LAlejandroCM/AnemoSense/BOM_Board1_Schematic1_2026-07-04.xlsx

No. | Quantity | Comment | Designator | Footprint | Value | Manufacturer Part | Manufacturer | Supplier Part | Supplier
1 | 7 | 10uF | C1,C2,C3,C4,C5,C6,C7 | C0805 | 10uF | C0805X106K010T | IHHEC(禾伸堂) | C340314 | LCSC
2 | 2 | 100nF | C8,C9 | C0805 | 100nF | CC0805KRX7R9BB104 | YAGEO(国巨) | C49678 | LCSC
3 | 1 | PRTR5V0U2X | D1 | SOT-143-4_L2.9-W1.3-P1.92-LS2.4-BL |  | PRTR5V0U2X | TECH PUBLIC(台舟) | C2827688 | LCSC
4 | 1 | MBR120LSFT1G | D2 | SOD-123_L2.8-W1.8-LS3.7-RD-1 |  | MBR120LSFT1G | onsemi(安森美) | C891416 | LCSC
5 | 1 | PM254V-11-07-H85 | H1 | GC9A01 |  | PM254V-11-07-H85 | XFCN(兴飞) | C2832270 | LCSC
6 | 1 | YLED1206W | LED1 | LED1206-R-RD |  | YLED1206W | YONGYUTAI(永裕泰) | C28310437 | LCSC
7 | 2 | MMBT2222ALT1G | Q1,Q2 | SOT-23-3_L2.9-W1.3-P1.90-LS2.4-BR |  | MMBT2222ALT1G | onsemi(安森美) | C82460 | LCSC
8 | 3 | 10kΩ | R2,R3,R7 | R0805 | 10kΩ | SCR0805J10K | VO(翔胜) | C5140188 | LCSC
9 | 1 | 80.6kΩ | R4 | R0805 | 80.6kΩ | CR0805F88062G | LIZ(丽智电子) | C101871 | LCSC
10 | 2 | 5.1kΩ | R5,R6 | R0805 | 5.1kΩ | HoAR0805-1/8W-5.1KR-0.1%-TCR25 | Milliohm(毫欧) | C2912598 | LCSC
11 | 1 | 100kΩ | R8 | R0805 | 100kΩ | SCR0805J100K | VO(翔胜) | C3017875 | LCSC
12 | 4 | 4.7kΩ | R9,R10,R11,R12 | R0805 | 4.7kΩ | FRC0805F4701TS | FOJAN(富捷) | C2907264 | LCSC
13 | 2 | PTS820J25MSMTRLFS | SW1,SW2 | KEY-SMD_6P-L3.9-W2.9_PTS820 |  | PTS820J25MSMTRLFS | C&K | C221900 | LCSC
14 | 1 | SCD41-D-R2 | U1 | XDCR_SCD41-D-R2
15 | 1 | CH340C | U2 | SOP-16_L10.0-W3.9-P1.27-LS6.0-BL |  | CH340C | WCH(南京沁恒) | C84681 | LCSC
16 | 1 | 2.4GHz | U3 | WIFI-SMD_ESP32-WROVER-E-N8R2 | 2.4GHz | ESP32-WROVER-IE-N16R8 | ESPRESSIF(乐鑫) | C701352 | LCSC
17 | 1 | 0805L100WR | U7 | F0805 |  | 0805L100WR | Littelfuse(美国力特) | C80270 | LCSC
18 | 1 | AP2112K-3.3TRG1 | U8 | SOT-23-5_L2.9-W1.6-P0.95-LS2.8-BR |  | AP2112K-3.3TRG1 | TECH PUBLIC(台舟) | C23380830 | LCSC
19 | 1 | BME680 | U9 | LGA-8_L3.0-W3.0-P0.80-TR |  | BME680 | Bosch(博世) | C125972 | LCSC
20 | 1 | U262-161N-4BVC11 | USB1 | USB-3.1-SMD_U262-161N-4BVC11 |  | U262-161N-4BVC11 | XKB Connection(中国星坤) | C319148 | LCSC
