LAlejandroCM/AnemoSense/SCH_Schematic1_2026-07-04.pdf

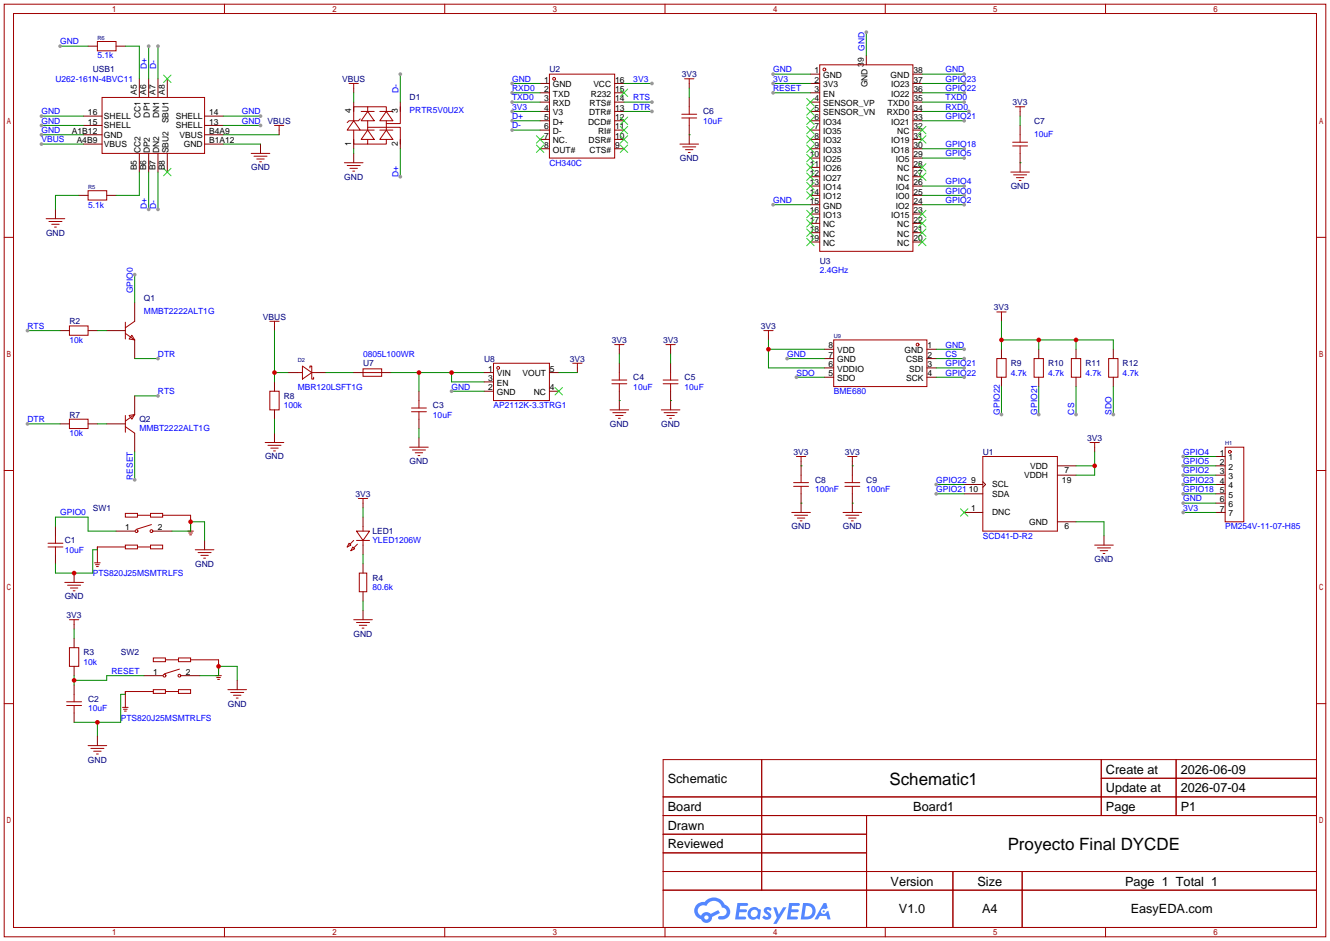
[picture p6: page 1]

DSR# 10 RI# 11 DCD# 12 DTR# 13 RTS# 14 R232 15 VCC 16

Schematic | Schematic1 | Create at | 2026-06-09

Update at | 2026-07-04

Board | Board1 | Page | P1
Drawn | | Proyecto Final DYCDE
Reviewed

Version | Size | Page 1 Total 1
V1.0 | A4 | EasyEDA.com
